todbot/TouchwheelSAO/docs/renders/TouchwheelSAO-render6.jpg

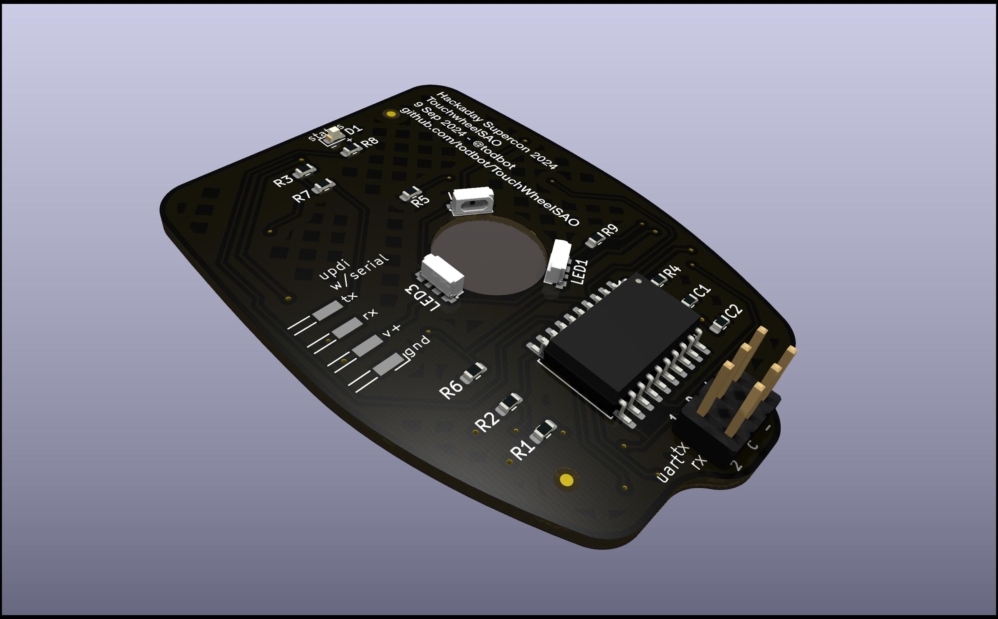
docs/renders/TouchwheelSAO-render6.jpg
