todbot/TouchwheelSAO/(threads)

Thread 1 (2024-11-10):

Fast I2C polling causes glitchy touch reading

todbot, 2024-11-10:
The touch reading code currently does not suspend interrupts during `TouchyTouch::rawRead()`.
This leads to bad touch data.
Discovered by @carlynorama by doing fast reads with no delay between reads.

To test, use [TouchwheelSAO_test](https://github.com/todbot/TouchwheelSAO/blob/main/firmware/tester/TouchwheelSAO_test/TouchwheelSAO_test.ino) Arduino code and comment out the `delay(100)`.

Closed 2024-11-10.
