todbot/TouchwheelSAO/schematics/TouchwheelSAO/TouchwheelSAO_sch.pdf

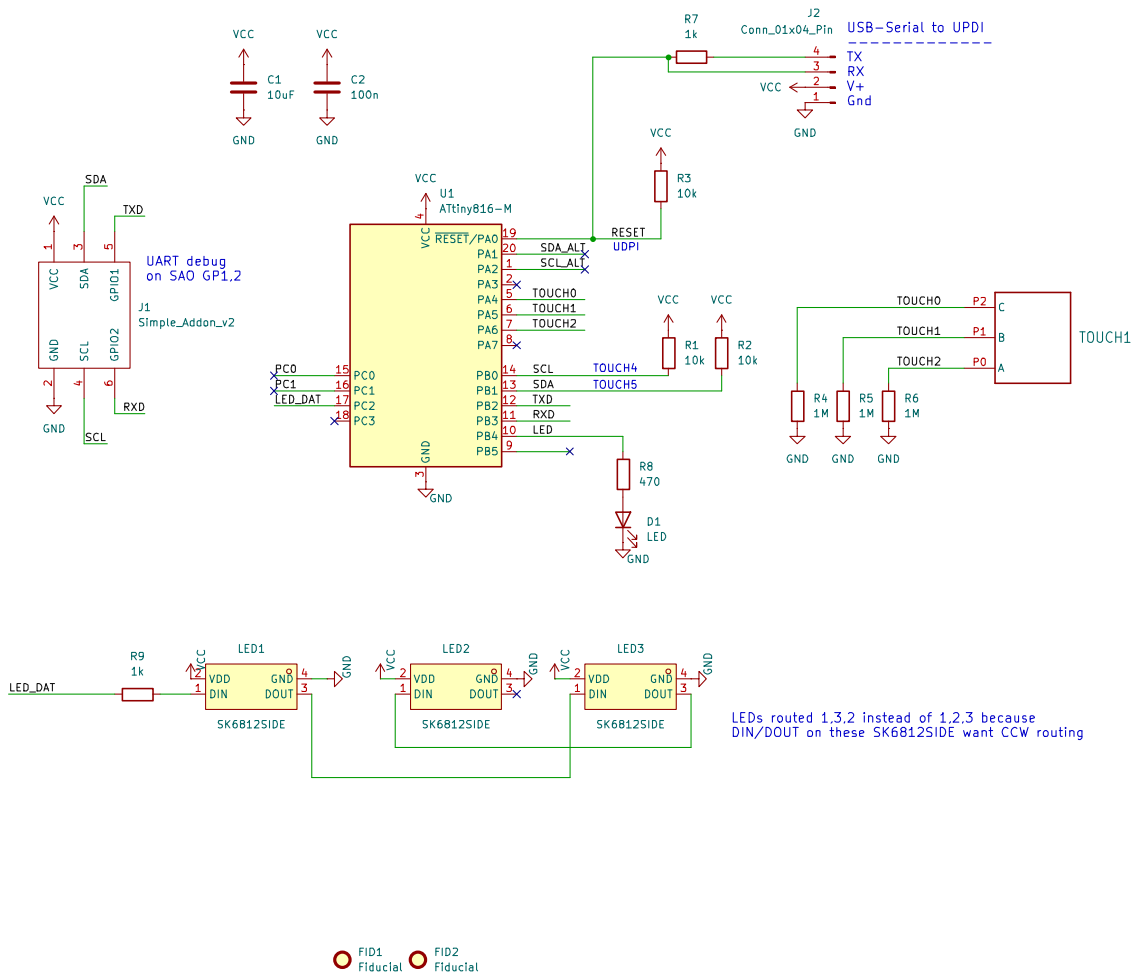
[picture p9: page 1]
