todbot/TouchwheelSAO/(commit log)

2024-08-12 add html bom
2024-08-17 add LED backlighting to center
    [TouchwheelSAO.kicad_pcb, TouchwheelSAO.kicad_sch]
2024-08-19 add neopixels
    [TouchwheelSAO.kicad_pcb, TouchwheelSAO.kicad_sch]
2024-08-20 add probably unecessary resistor on neopixel input
    [TouchwheelSAO.kicad_pcb, TouchwheelSAO.kicad_sch]
2024-08-20 update bom
2024-08-20 update bom, for realsies
    [TouchwheelSAO.kicad_pcb, TouchwheelSAO.kicad_sch]
2024-08-20 fix offset mask circles
    [TouchwheelSAO.kicad_pcb]
2024-08-28 test against real board, still needs work
2024-08-28 updi pads now 0.1 inch spacing
    [TouchwheelSAO.kicad_pcb, TouchwheelSAO.kicad_sch]
2024-08-28 fixup RGB LED ring response
    [TouchwheelSAO_attiny816.ino, code.py]
2024-08-28 switch ws2812 driver to save 500 bytes
2024-08-28 update sch
    [TouchwheelSAO.kicad_sch]
2024-08-30 code on boards given to Giovanni
2024-08-31 pcb part packaging changes to fit DesignLab PnP afer meeting w/ Giovanni
    [TouchwheelSAO.kicad_pcb, TouchwheelSAO.kicad_sch]
2024-09-01 new easier-to-hand-assmeble boards sent to fab
    [TouchwheelSAO.kicad_pcb]
2024-09-07 update bom to new pcb
2024-09-07 add LED brightness since new PCBs LEDs are so nice and bright
2024-09-08 switch to integer version of wheel_pos() to save 1.2kB
2024-09-09 Update README.md to add prototype demo video
2024-09-10 add fiducials to PCB
    [TouchwheelSAO.kicad_pcb, TouchwheelSAO.kicad_sch]
2024-09-12 pcb cleanup
    [TouchwheelSAO.kicad_pcb]
2024-09-14 finalize silkscreen per Giovanni, add renders, update BOM and production files
    [TouchwheelSAO.kicad_pcb, TouchwheelSAO.kicad_sch]
2024-09-17 back to QFN for ATtiny for JLC PCBA
    [TouchwheelSAO.kicad_pcb, TouchwheelSAO.kicad_sch, bom.csv, positions.csv]
2024-09-17 NOTE: hand-switch position of SAO 2x3 header from bottom to top to match what JLC expects
    [positions.csv]
2024-09-19 make front silkscreen even more minimal, per Giovanni
    [TouchwheelSAO.kicad_pcb]
2024-10-22 add another recalibration after startup demo, for bad touch / spotty power
2024-11-09 added arduino host example
2024-11-10 suspend interrupts while reading touch, hopefully fixes #1
    [TouchyTouch.h]
2026-11-08 firmware update adds I2C cmds to set individual RGB LEDs
2026-11-08 remove printf that was slowing things down
2026-11-08 add i2c protocol details to readme
